hkgvaug/gripper_fingers/README.md

# SCHUNK PSH 32-1 参数化 3D 打印夹爪手指

工作目录：`D:\ubuntutowin\bimros\gripper_fingers\`  
日期：2026-10-21  
单位：全文及所有 CAD 文件均为 **mm**。  
说明：本目录是新建目录，未改动 `ros1_ws/` 内任何包，也没有重新导出/修改 SCHUNK 夹爪本体。建模、文件生成和离线检查之外，**没有运行任何驱动真机的命令**。

---

## 0. 结论先行

| 项目 | 结果 |
|---|---|
| SCHUNK 官方最大允许指长 | **170 mm**（6 bar 名义压力） |
| 本设计指长 | **150 mm**（总长；从基爪上边缘量到指尖为 156.5 mm，仍小于 170） |
| 为什么不用 200–250 mm | 200/250 mm 分别超出官方上限约 18%/47%；手册还要求更高压力时按比例缩短。超限会放大根部弯矩、挠度和碰撞风险，不能靠加厚打印件绕过。 |
| 单指质量（PETG 1.27 g/cm³） | **约 213 g** |
| 单指质量（PA12-CF 1.10 g/cm³） | **约 184 g** |
| 一对质量 | PETG **约 425 g**；PA12-CF **约 368 g** |
| 官方单指质量上限 | **1.5 kg**（本设计远低于该值） |
| 指板闭合间隙 / 全开间隙 | **40 / 110 mm**；贴 2 mm 橡胶垫后 **36 / 106 mm** |
| 装配姿态 | 按夹爪 STL 的闭合位叠加；与本体进行布尔相交检查，**相交体积 0 mm³** |
| STL 检查 | 左右指各 1 个封闭实体，装配 STL 为 2 个封闭实体；全部 watertight，打印件 Z 最低点≈0 |

> 200–250 mm 的方案**没有采用**。如果确实需要 200–250 mm 的悬伸，应该换更大规格夹爪、增加刚性转接件并重新校核，或者在 SCHUNK 书面确认下降低气压/夹持力；不建议直接打印更长的指板。

---

## 1. 官方允许上限（先查）

SCHUNK PSH 32-1（ID 302132）官方产品页/数据表给出的关键值：

| 参数 | 官方值 |
|---|---:|
| 最大允许指长（nominal 6 bar） | **170 mm** |
| 每指最大允许质量 | **1.5 kg** |
| 最大弯矩 Mx | **20 N·m** |
| 最大弯矩 My | **10 N·m** |
| 最大弯矩 Mz | **10 N·m** |
| 最大轴向力 Fz | **300 N** |
| 单爪行程 | **35 mm** |
| 闭合/张开力（两爪算术和） | **750 N**（约 375 N/爪） |
| 本体尺寸 / 质量 | 171 × 76 × 63 mm / 2.05 kg |
| 名义工作压力 | 6 bar（3–8 bar） |

官方说明要点：

- “Gripping force is the arithmetic sum of the individual force applied to each jaw.” 所以 750 N 按两爪分担，本报告按 **375 N/爪** 做初步校核。
- 最大指长对应名义压力 6 bar；超过名义压力时，允许指长要按压力比例缩短。
- 最大指长是从基准面沿手指方向到主轴的投影 P；因此本设计采用更保守的“整体长度”控制。
- Mx/My/Mz/Fz 是每个基爪的静态许用值，可以同时出现，且是“夹持力自身产生的弯矩之外”的外部载荷。不能用 10 N·m 直接反推“指尖可以随便施加 66 N”；夹持力自身的弯矩仍然存在。

来源：
- [SCHUNK PSH 32-1 官方产品页](https://schunk.com/sg/en/gripping-systems/parallel-gripper/psh/psh-32-1/p/000000000000302132)
- [SCHUNK PSH 系列数据表 PDF（bibus 镜像）](https://www.bibus.cz/fileadmin/editors/countries/bisro/downloads/AUTOMATIZACE_A_PNEUMATIKA/SCHUNK/schunk_series_psh_datasheet_en.pdf)
- [SCHUNK 抓取模块目录（PSH 章节）](https://www.bibus.cz/fileadmin/editors/countries/bisro/downloads/AUTOMATIZACE_A_PNEUMATIKA/SCHUNK/schunk_catalogue_gripping_modules_en_2009.pdf)
- [SCHUNK PSH 32 装配/操作手册（第 19 页，M5 基爪连接螺纹）](https://www.manualslib.com/manual/1790429/Schunk-Psh-32.html?page=19)

> 手册第 19 页的完整表格在抓取时被网站防护拦截，只确认了 **PSH 32 基爪连接螺纹为 M5** 和“有最大旋入深度限制”。**M5 螺纹的实际有效深度、螺钉最终扭矩**仍需按纸质/官网手册或实物核对，见“待确认”清单。

---

## 2. 从 STL 实测到的接口

测量对象：`SCHUNK-0302132 PSH 32-1_ 0000.stl`（STL 为 ASCII，整体包围盒 175 × 63 × 76 mm）。  
测量方法：解析三角面、按平面/圆柱面聚类、在 x=85.5、x=64 等平面做截面并与官方 171 × 76 × 63 尺寸交叉核对。

### 2.1 基爪安装面

| 项目 | 实测值 |
|---|---:|
| 安装面尺寸（Y × Z） | **60.0 × 73.0 mm** |
| 安装面 Y 范围 | 1.5 … 61.5 mm（中心 31.5） |
| 安装面 Z 范围 | −36.5 … +36.5 mm（中心 0） |
| 夹爪整体 X 尺寸 | 175 mm（官方 171 mm，STL 含圆角/倒角） |

### 2.2 四个 M5 孔位

右基爪外侧面（X = +85.5）的孔位，相对安装面中心 (Y=31.5, Z=0)：

```
                 (Y,Z) = (0, +20)
(-20, 0)                              (+20, 0)
                 (Y,Z) = (0, -20)
```

即绝对坐标：

| 孔 | Y (mm) | Z (mm) |
|---|---:|---:|
| 1 | 11.5 | 0 |
| 2 | 31.5 | +20 |
| 3 | 51.5 | 0 |
| 4 | 31.5 | −20 |

四孔呈 **40 × 40 mm 菱形**（相邻孔中心距约 28.28 mm）。

孔特征：

- STL 通孔实测约 **Ø4.92 mm**（按名义 Ø5.0 处理）。
- 外侧面有 **Ø10 × 3 mm 沉孔**。
- SCHUNK 手册确认该连接螺纹为 **M5**。
- 本设计按 **M5 螺钉穿过打印指根、旋入基爪 M5 螺纹** 的方式设计；指根上做 Ø5.7 通孔 + Ø9.2 × 5 mm 沉孔（含 +0.2 mm 公差补偿）。

### 2.3 导向杆让位

STL 中 4 根导向杆在外侧面之外还有约 **2 mm** 凸出，位置：

| 位置 (Y,Z) | 杆截面约 | 让位槽（本设计） |
|---|---:|---:|
| (19, +19) | 10 × 10 | 11.5 × 11.5 × 2.3 mm |
| (19, −19) | 10 × 10 | 11.5 × 11.5 × 2.3 mm |
| (50, +18) | 14 × 14 | 16 × 16 × 2.3 mm |
| (50, −18) | 14 × 14 | 16 × 16 × 2.3 mm |

> 左右两侧的杆端位置不同，因此指根把四个让位槽都做出来（多出的槽不影响结构，方便左右镜像通用）。如果实物没有这些凸出，可以让位槽保留，不影响安装。

### 2.4 张开间距

| 项目 | 数值 |
|---|---:|
| STL 姿态（按整体长度判断为闭合位）外侧安装面间距 | **171 mm** |
| 每爪行程 | +35 mm（向外张开） |
| 全开时外侧安装面间距 | 171 + 2×35 = **241 mm** |
| 本设计指板内侧面间隙（闭合，不含垫） | **40 mm** |
| 本设计指板内侧面间隙（全开，不含垫） | **110 mm** |
| 贴 2 mm 橡胶垫后的闭合/全开间隙 | **36 / 106 mm** |

> “STL 姿态为闭合位”是**推断**：STL 的 X 尺寸 175 mm 与官方闭合外形 171 mm 接近，且基爪向外的运动方向不会与中间壳体相撞。请用实物确认全开方向与行程。

### 2.5 木构件截面（未给出，占位）

用户没有给出木构件截面。本设计用：

- **木构件宽度占位值：40 mm**（用于确定指板闭合间隙和左右偏移）。
- 橡胶垫接触长度占位：**60 mm**。
- 构件高度/厚度、实际夹持位置：未知。

因此 `GRIP_GAP_CLOSED = 40.0` 和 `PAD_THICKNESS = 2.0` 都是**占位值**，确认后改脚本顶部参数并重新生成即可。若木构件宽度大于 106 mm，本手指在 6 bar 下会夹不到；需要加长/重做支撑结构。

---

## 3. 设计说明

### 3.1 安装方向

参考照片中可见的螺钉头和外侧面沉孔，本设计把指根安装在**基爪外侧面**（X = ±85.5），而不是两爪相对的内侧面。这样：

1. 完全避开 4 根从外侧面凸出的导向杆；
2. 让指板从夹爪本体下方绕入，避免与中间壳体碰撞；
3. 仍然保留 M5 螺钉从外部装入、便于拆装的方向。

指根用四个 M5 螺钉从外侧穿过，旋入基爪螺纹。指根背面做四组导向杆让位槽。指板先向下伸到本体下方，再向内折到工件两侧，形成“外侧根部 → 下方横臂 → 内侧长指板”的 Z 形截面。

> 这是为了**无支撑打印 + 避让本体**做的折中。照片中的指板在夹爪前方，本设计在夹爪下方绕入；如果工件必须从前方进入、或下方净空不足，需要改成两件式前置支架（打印件 + 金属转接板），请先确认工艺空间。

### 3.2 主要尺寸

| 参数 | 默认值 | 说明 |
|---|---:|---|
| 指板总长（根顶到指尖） | 150 mm | 从基爪上边缘量到指尖为 156.5 mm，仍 < 170 |
| 指板宽度（Y） | 58 mm | 与 60 mm 安装面留 1 mm 边 |
| 根板宽 × 高 × 厚 | 58 × 60 × 14 mm | 与基爪外侧面贴合 |
| 长指板厚度（X） | 16 mm | 承弯主截面 |
| 内侧偏移（从外侧面到指板内表面） | 65.5 mm | 由 40 mm 闭合间隙反算 |
| 下方横臂高度 / 与本体间隙 | 12 mm / 2 mm | 横臂顶面低于本体底面 2 mm |
| 橡胶垫槽 | 36 × 60 × 2 mm | 槽底为平面，可贴 NBR/VHB |
| 根部内圆角 | R6 / R2 | 指板-横臂 R6；横臂-根板 R2 小加强角 |
| 外缘倒角 | 0.8 mm | 根板外侧面/指尖周缘 |
| 安装孔 | 4 × Ø5.7 通孔 + Ø9.2 × 5 沉孔 | +0.2 mm 补偿后 |
| 安装螺纹 | M5（在基爪上） | 建议 M5×16 SHCS |
| 导向杆让位 | 11.5×11.5 / 16×16 × 2.3 mm | 见 2.3 |

设计上：

- 根板与长指板之间的 12 mm 高横臂相当于全宽加强筋，配合 R6 内圆角降低应力集中；
- 长指板在 16 mm 厚度下，按 375 N/爪、150 mm 力臂做简化梁计算，名义弯曲应力约 **22.7 MPa**（未计孔/槽/打印各向异性/疲劳）；
- 指板内侧保留 36 × 60 mm 的平面垫槽，贴橡胶垫后不会形成点接触；
- 所有悬伸都位于夹爪本体下方，打印时侧放在平台上，不需要支撑；
- 导向杆让位槽与最近的 M5 沉孔之间最小壁厚约 **2.1 mm**；PETG 打印时注意层间强度，优先 PA12-CF。

### 3.3 质量与重心

从 STL 体积计算（不含螺钉/橡胶垫）：

| 项目 | PETG (1.27 g/cm³) | PA12-CF (1.10 g/cm³) |
|---|---:|---:|
| 单指 | 212.5 g | 184.0 g |
| 一对 | 425.0 g | 368.1 g |

单指重心（右指，装配坐标）：约 **(59.1, 31.4, −47.4) mm**；相对外侧面内移约 **26.4 mm**、低于基爪中心约 **47.4 mm**。

---

## 4. 文件说明

```
gripper_fingers/
├─ gripper_fingers.py              # 参数化 CadQuery 脚本；所有参数在文件开头
├─ README.md                       # 本文件
├─ inspect_stl.py                  # STL 封闭性/体积/包围盒检查
├─ check_collision.py              # 与 SCHUNK 本体做布尔相交检查
├─ build_report.json               # 构建参数、尺寸、质量、校核汇总
├─ stl_checks.json                  # STL 检查结果
├─ collision_check.json            # 碰撞检查结果
├─ preview_assembly.png            # 装配预览（仅图片，非 CAD 交付）
├─ preview_print.png               # 打印姿态预览
├─ stl/
│  ├─ finger_right_print.stl       # 右指（+X 爪），已放平到打印面
│  ├─ finger_left_print.stl        # 左指（−X 爪），已放平；右指的镜像
│  └─ fingers_pair_assembly.stl    # 一对指，按夹爪 STL 坐标摆放（闭合位）
├─ urdf/
│  ├─ finger_right_assembly.stl    # 右指，装配坐标（用于 URDF 分体/动画）
│  └─ finger_left_assembly.stl     # 左指，装配坐标
└─ step/
   ├─ finger_right.step
   ├─ finger_left.step
   └─ fingers_pair_assembly.step
```

### 4.1 打印 STL 的坐标/朝向

`finger_*_print.stl`：

- 已旋转为“侧面贴平台”：**Z = 0 为打印床面**；
- 指根顶面在 **Y = 0**，指尖在 **Y = 150**；
- 总包围盒约 **79.5 × 150 × 58 mm**（X × Y × Z）；
- 原点在指板内侧/根顶/近床侧面的角点；
- 直接切片，不需要支撑。

> 安装孔沿打印 X 方向，是水平孔。FDM 打印时孔顶会有轻微下垂；建议打印后用手钻/铰刀把 4 个孔修到 **Ø5.7**、沉孔修到 **Ø9.2 × 5**，再试装。PA12-CF SLS/MJF 通常不需要修孔。

### 4.2 装配 STL 与 URDF

`stl/fingers_pair_assembly.stl` 和 `urdf/*_assembly.stl` 使用与 SCHUNK STL **完全相同的坐标系**（X 向、Y 向、Z 向都不需要额外平移/旋转），因此可直接在 URDF 中叠加。

建议的静态可视化/碰撞方式（不修改 SCHUNK 模型）：

```xml
<link name="psh32_with_fingers">
  <visual name="body">
    <geometry><mesh filename="file:///path/to/SCHUNK-0302132 PSH 32-1_ 0000.stl"/></geometry>
  </visual>
  <visual name="fingers">
    <geometry><mesh filename="file:///path/to/gripper_fingers/stl/fingers_pair_assembly.stl"/></geometry>
  </visual>
  <collision name="body">
    <geometry><mesh filename="file:///path/to/SCHUNK-0302132 PSH 32-1_ 0000.stl"/></geometry>
  </collision>
  <collision name="fingers">
    <geometry><mesh filename="file:///path/to/gripper_fingers/stl/fingers_pair_assembly.stl"/></geometry>
  </collision>
</link>
```

> 版权说明：原始 SCHUNK STL 标注为 **CC BY-ND 4.0**（SCHUNK / CADENAS）。把本体和手指合并成一个修改后的 STL 可能构成改编；因此本目录**没有**提供合并了本体的装配 STL。上面的方式保留原始网格原样，只把两个网格放在同一坐标系中显示/碰撞，推荐用于 URDF。若要关节动画，可把 `urdf/` 中的单指网格分别挂到左右基爪 link，并按行程沿 X 平移；需要我按你们的 URDF 关节轴再生成局部坐标版本即可。

---

## 5. 检查结果

### 5.1 STL 几何

| 文件 | 实体数 | Watertight | 体积 | PETG 质量 |
|---|---:|---|---:|---:|
| `finger_right_print.stl` | 1 | true | 167.32 cm³ | 212.5 g |
| `finger_left_print.stl` | 1 | true | 167.32 cm³ | 212.5 g |
| `fingers_pair_assembly.stl` | 2 | true（逐体） | 334.64 cm³ | 425.0 g |
| `urdf/finger_right_assembly.stl` | 1 | true | 167.32 cm³ | 212.5 g |
| `urdf/finger_left_assembly.stl` | 1 | true | 167.32 cm³ | 212.5 g |

- 所有文件 **watertight = true**，winding consistent；
- STL 不携带单位元数据，但建模/导出均按 **mm**，尺寸与夹爪接口交叉核对；
- 打印件包围盒约 **79.5 × 150 × 58 mm**，Z 最低点约 **−0.007 mm**（切片容差，可视为贴床）；
- 双指装配包围盒约 **199.0 × 58.0 × 150.0 mm**（X × Y × Z，闭合位；指根在基爪外侧，所以整体比本体宽）；
- 单指体积 **167.32 cm³**；按 PETG 1.27、PA12-CF 1.10 g/cm³ 估算质量；
- 与原始 SCHUNK STL 的布尔相交：左右指均为 **0 mm³**（`collision_check.json`）。
- 本设计的最大指长检查：总长 150 mm；从基爪上边缘量到指尖 **156.5 mm < 170 mm**。

### 5.2 强度/力矩初步校核（非认证分析）

- 夹持力按 750 N 两爪分担：**375 N/爪**。
- 指尖到根部的力臂按 150 mm：根部夹持弯矩约 **56.3 N·m**。
- 长指板 58 × 16 mm 的截面模量约 **2474.7 mm³**，名义弯曲应力约 **22.7 MPa**。
  - PA12-CF 抗拉强度通常约 60–80 MPa，静态名义安全系数约 3；
  - PETG 抗拉约 45–55 MPa，静态名义安全系数约 2；
  - 以上**未计入**孔、让位槽、打印层间强度、缺口、疲劳和夹持冲击。实际使用前，在不超过夹爪额定 750 N 的前提下，按实际工作夹持力的 1.5–2 倍做静载/循环试验（夹持木块，不要空夹）。
- 官方 My/Mz 上限 10 N·m 指外部静载。若在 150 mm 处施加侧向力，10 N·m 对应约 66.7 N；Mx 20 N·m 对应约 133 N。实际还要叠加夹持力自身产生的弯矩，不能只看这个数。
- 手指自重相对基爪的静力矩：约 **0.055 N·m/指**（PETG），一对约 **0.11 N·m**，远小于 10 N·m；但这是对基爪的局部值，**不是**力传感器处的总力矩。

### 5.3 对力传感器/腕部力矩的提醒

手指自重和长力臂会额外增加末端力矩，并且会改变工具重心的位置：

- 一对指板质量：PETG **约 0.425 kg**，PA12-CF **约 0.368 kg**；还要加 8 颗 M5 螺钉和橡胶垫。
- 例：若力传感器到指板重心的水平距离为 **0.2 m**，一对 PETG 手指的静态重力矩约  
  `0.425 × 9.81 × 0.2 ≈ 0.83 N·m`；若为 **0.5 m**，约 **2.08 N·m**。
- 这还没算：夹爪本体 2.05 kg、木构件重量、加减速惯性力、碰撞/接触力。做力控/阻抗控制前，请重新做工具重力补偿和零点标定；不要沿用空夹爪的补偿参数。
- 手指越重、重心越远，腕部关节和力传感器的偏置/噪声越大；建议先用 PA12-CF 减重，必要时在保证强度的地方加减轻孔（本版为了无支撑打印和强度，未做减重孔）。

---

## 6. 打印与装配建议

### 6.1 材料

- **首选 PA12-CF（SLS/MJF）**：各向同性、刚度和疲劳优于 FDM PETG，孔和让位槽尺寸稳定，适合夹持工件。
- PETG（FDM）可用于轻载/样机：建议 0.4–0.6 mm 喷嘴、5–6 圈壁、50–60% 填充、干燥耗材；层间强度较弱，避免长期满载/高温。
- 不建议普通 PLA（脆、蠕变、耐温低）。

### 6.2 打印

- 使用 `stl/*_print.stl`，**侧面平放**，Z=0 贴床；不要再次旋转。
- 不需要支撑；检查 4 个水平安装孔和沉孔内部是否有毛刺，打印后修孔。
- 打印件与基爪接触的根板背面有 4 个让位槽；装配前清理槽内支撑/毛刺，确认能贴合外侧面。
- 橡胶垫：建议 2 mm 厚 NBR 70A（或类似），尺寸 36 × 60 mm，贴入 2 mm 深垫槽；用氰基丙烯酸酯或 VHB 胶带。垫厚改变时同步修改 `PAD_THICKNESS` 并重算间隙。

### 6.3 紧固

- 每指 **4 × M5×16 内六角圆柱头螺钉**（SHCS），从指根外侧穿入，旋入基爪 M5 螺纹；按根板 14 mm、沉孔 5 mm 计算，约 **7 mm 旋入基爪**。
- 指根上孔径 Ø5.7、沉孔 Ø9.2×5（已含 +0.2 mm 补偿）。
- 螺纹旋入深度、最终扭矩按 SCHUNK PSH 手册的表格执行；本次只确认了 M5 与“有最大旋入深度限制”，**没有确认具体深度/扭矩值**，不要凭空用大扭矩。建议先用手拧入，确认不顶底，再按手册分步拧紧。
- 建议中强度螺纹胶；避免螺钉头低于根板表面过多导致应力集中。

### 6.4 装配顺序

1. 打印左右指，清理孔/槽；
2. 试装橡胶垫，确认垫面平整；
3. 把左右指分别贴到基爪外侧面，确认四个让位槽对准导向杆、四个 M5 孔对准螺纹；
4. 先手动拧入四颗 M5×16，确认不偏斜、不顶底，再按手册扭矩拧紧；
5. 手动/低速点动确认全行程无干涉；**不要直接跑高速/带载程序**；
6. 重新做工具重力补偿和力传感器零点，再测试夹持。

---

## 7. 待我确认（占位值/未给参数）

请重点确认以下项；括号内是当前临时值：

- [ ] **木构件截面**：当前占位宽度 40 mm、橡胶垫接触长度 60 mm；实际宽度/高度/夹持方向？（`GRIP_GAP_CLOSED=40`, `PAD_LENGTH=60`）
- [ ] **实际夹持间隙**：闭合时两指板内表面间隙要 40 mm 是否合适？贴 2 mm 垫后当前为 36 mm，需要夹 40 mm 时夹爪需多开约 4 mm。
- [ ] **安装面方向**：按照片和沉孔方向采用“外侧面安装”；实物 M5 螺纹到底在外侧面还是内侧面？请用实物确认。
- [ ] **M5 螺纹有效深度**：手册只确认 M5，没有确认 PSH 32-1 的 max engagement；M5×16 是否会顶底？
- [ ] **螺钉扭矩**：按 SCHUNK 手册 7.6 表格，而不是通用 M5 扭矩。
- [ ] **STL 姿态/行程方向**：当前按闭合位、向外 35 mm/爪；请确认全开方向和实际总行程。
- [ ] **指长需求**：150 mm 总长是否够用？若需要更长，必须保持在 170 mm 以内并重新校核；200–250 mm 不建议。
- [ ] **橡胶垫**：厚度 2 mm、硬度 70A、胶接方式是否合适？垫片厚度会影响实际间隙和夹持力。
- [ ] **下方净空**：本设计从本体下方绕入。机器人/工作台/工件是否会碰到下方横臂和指板？
- [ ] **载荷/速度/工件重量**：用于做疲劳、惯性和力传感器力矩校核；当前只做了静态简化估算。
- [ ] **是否需要走线槽/传感器安装孔/减重孔**：当前未设计。

---

## 8. 复现/修改

环境（当前机器已安装）：

```bash
cd D:\ubuntutowin\bimros\gripper_fingers
python gripper_fingers.py       # 重新生成 STL/STEP/report
python inspect_stl.py           # 检查封闭性、体积、包围盒
python check_collision.py       # 与 SCHUNK 本体做布尔相交检查
```

依赖：`cadquery`、`trimesh`、`manifold3d`、`rtree`。  
所有可调参数都在 `gripper_fingers.py` 的 **1. USER PARAMETERS** 段（文件开头），包括：

- 指板总长、宽度、厚度、根部台阶尺寸、横臂高度；
- 闭合指板间隙、垫片厚度/尺寸；
- 安装孔径、孔距、M5 螺纹、+0.2 mm 孔补偿；
- 根部圆角、倒角、导向杆让位槽；
- 官方上限（用于脚本内硬校验）。

修改 `GRIP_GAP_CLOSED` 或 `PAD_THICKNESS` 后一定要重新跑 `gripper_fingers.py` 和 `inspect_stl.py`，并再次确认包围盒/间隙。

---

## 9. 已知限制

- 本设计是**静态几何/初步强度校核**，不是认证的疲劳/冲击分析；3D 打印件的层间强度和缺口敏感性需要试验。
- 手指从夹爪下方绕入是避让本体和导向杆的结果；与参考照片的“前方指板”不完全相同，必须先确认工件进入方向和下方净空。
- STL 没有单位；所有接口尺寸按 mm 解释。不同打印机收缩会导致孔位偏差，建议先打印一件做孔位/让位槽试配。
- 没有包含螺钉、垫片、螺纹胶、线缆和传感器的质量/几何。
- M5 螺纹深度/扭矩、实际夹持截面仍需用户确认后才能作为最终版。

---

## 10. 参考

- SCHUNK PSH 32-1 产品页：<https://schunk.com/sg/en/gripping-systems/parallel-gripper/psh/psh-32-1/p/000000000000302132>
- SCHUNK PSH 系列数据表（PDF）：<https://www.bibus.cz/fileadmin/editors/countries/bisro/downloads/AUTOMATIZACE_A_PNEUMATIKA/SCHUNK/schunk_series_psh_datasheet_en.pdf>
- SCHUNK PSH 32 装配/操作手册（第 19 页，M5 基爪连接）：<https://www.manualslib.com/manual/1790429/Schunk-Psh-32.html?page=19>
- 原始 CAD 许可：`CC-BY-ND-4.0`（SCHUNK SE & Co. KG / CADENAS GmbH，随 STL 提供）
