hkgvaug/gripper_fingers/urdf/finger_right_assembly.stl

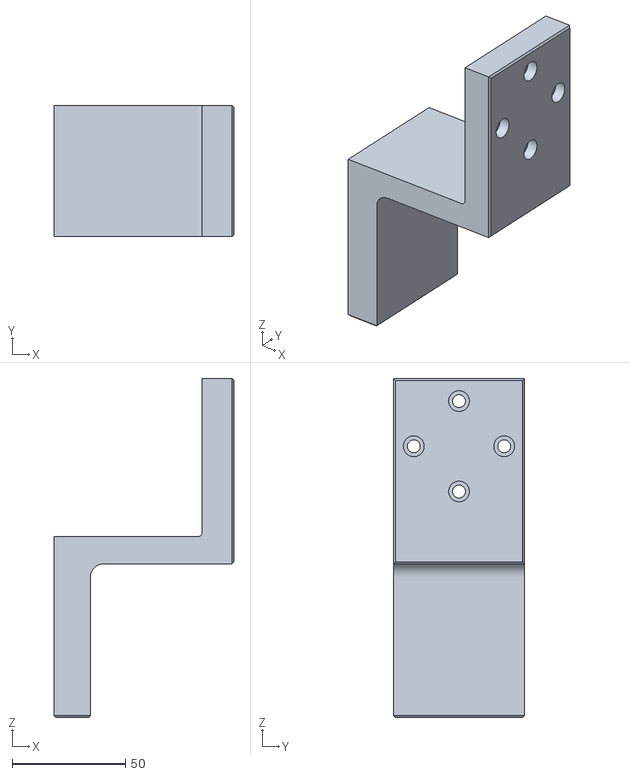
[picture p1: CAD file, 2026-10-22]
urdf/finger_right_assembly.stl
79.5 x 58.0 x 150.0
