hkgvaug/gripper_fingers/step/fingers_pair_assembly.step

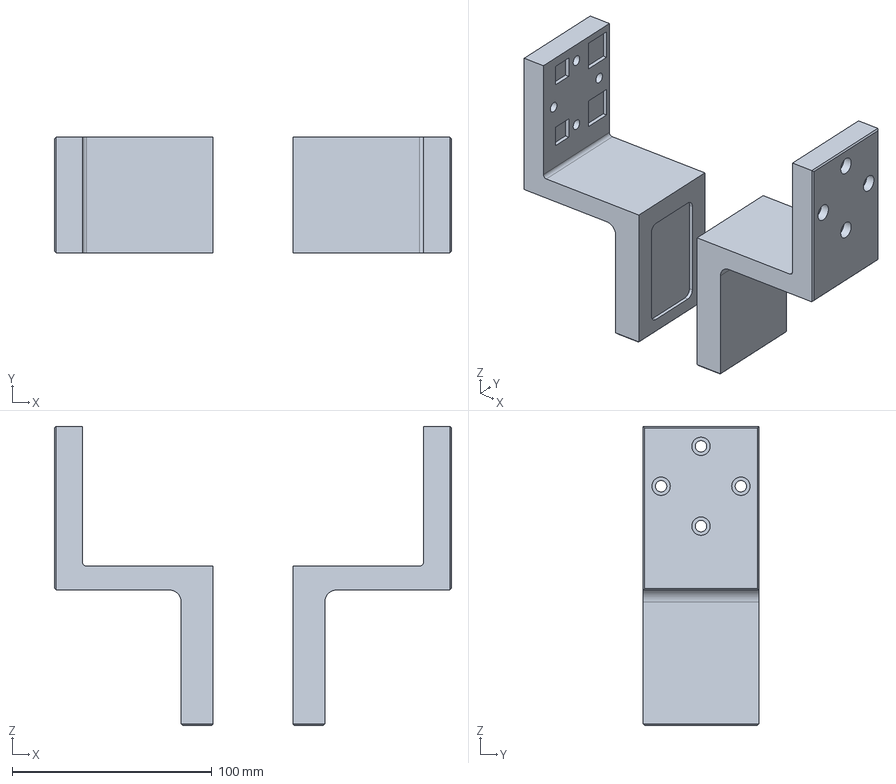
[picture p2: CAD file, 2026-10-22]
step/fingers_pair_assembly.step
199.0 x 58.0 x 150.0 mm
