hkgvaug/gripper_fingers/(list of files, cad)

Other CAD files:
urdf/finger_left_assembly.stl
step/finger_left.step
stl/finger_right_print.stl
step/finger_right.step
stl/finger_left_print.stl
stl/fingers_pair_assembly.stl
