hkgvaug/gripper_fingers/preview_assembly.png

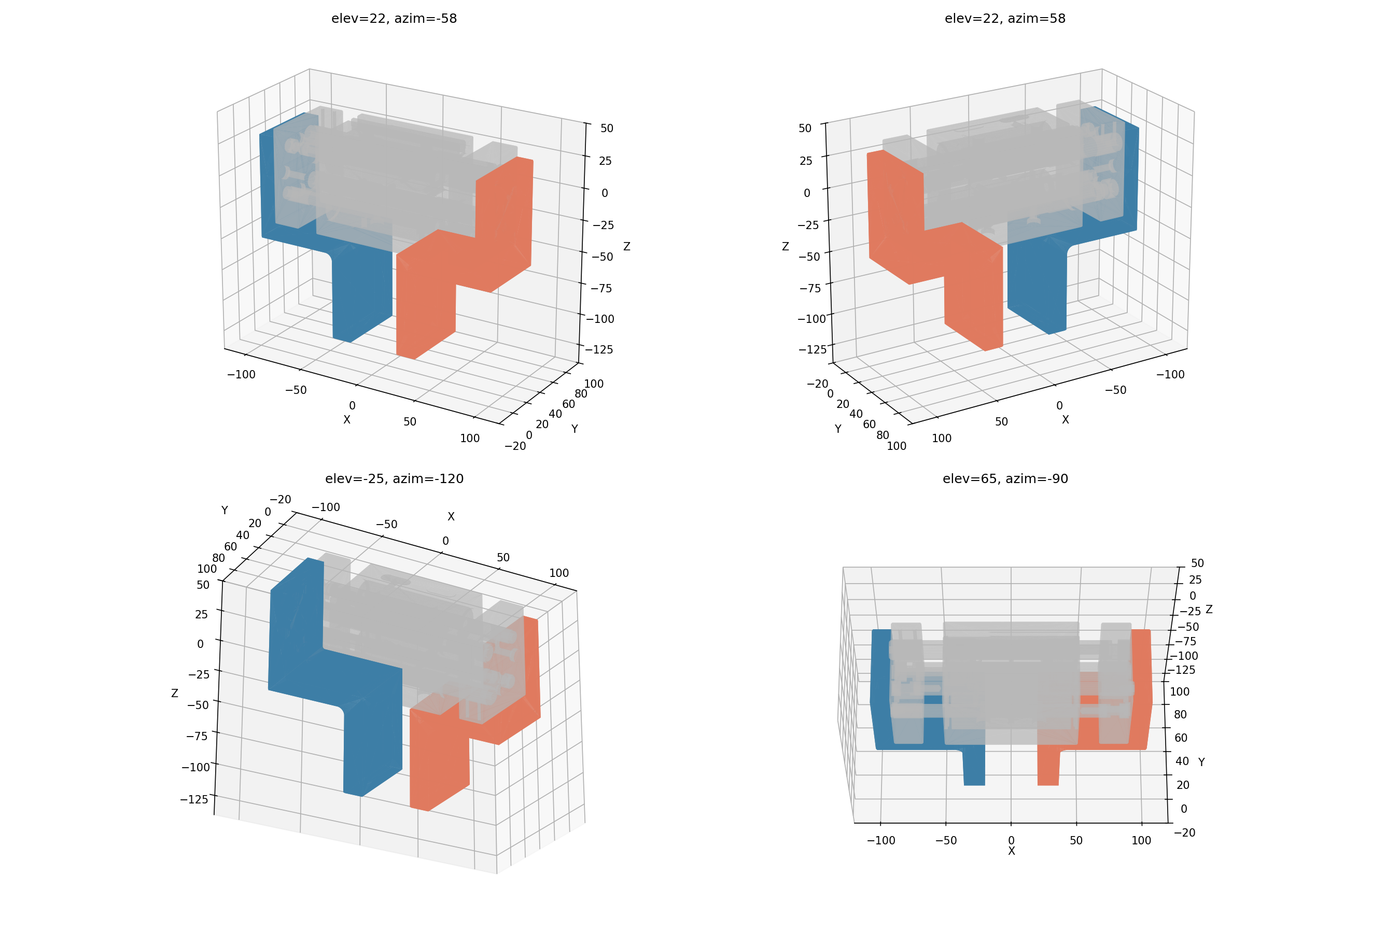
preview_assembly.png
