hkgvaug/gripper_fingers/preview_print.png

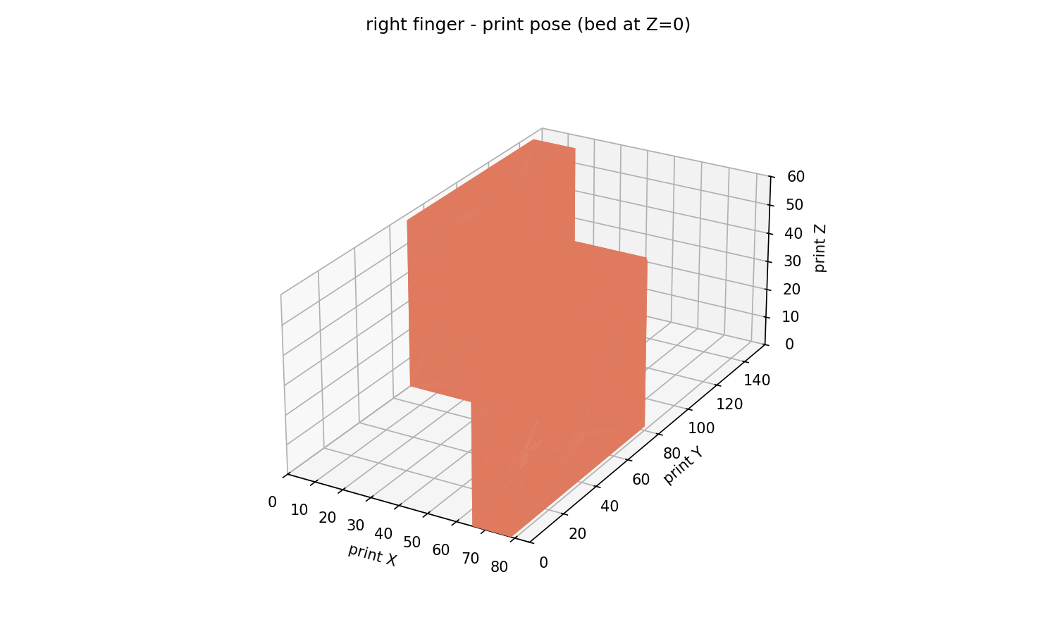
preview_print.png
